Pepito-electronics/Integrated-KART/README.md

# Integrated-KART
Conception d'un KART électrique
