Pepito-electronics/Integrated-KART/Gr13_rapport_final.pdf

# ISAT – EPHEC

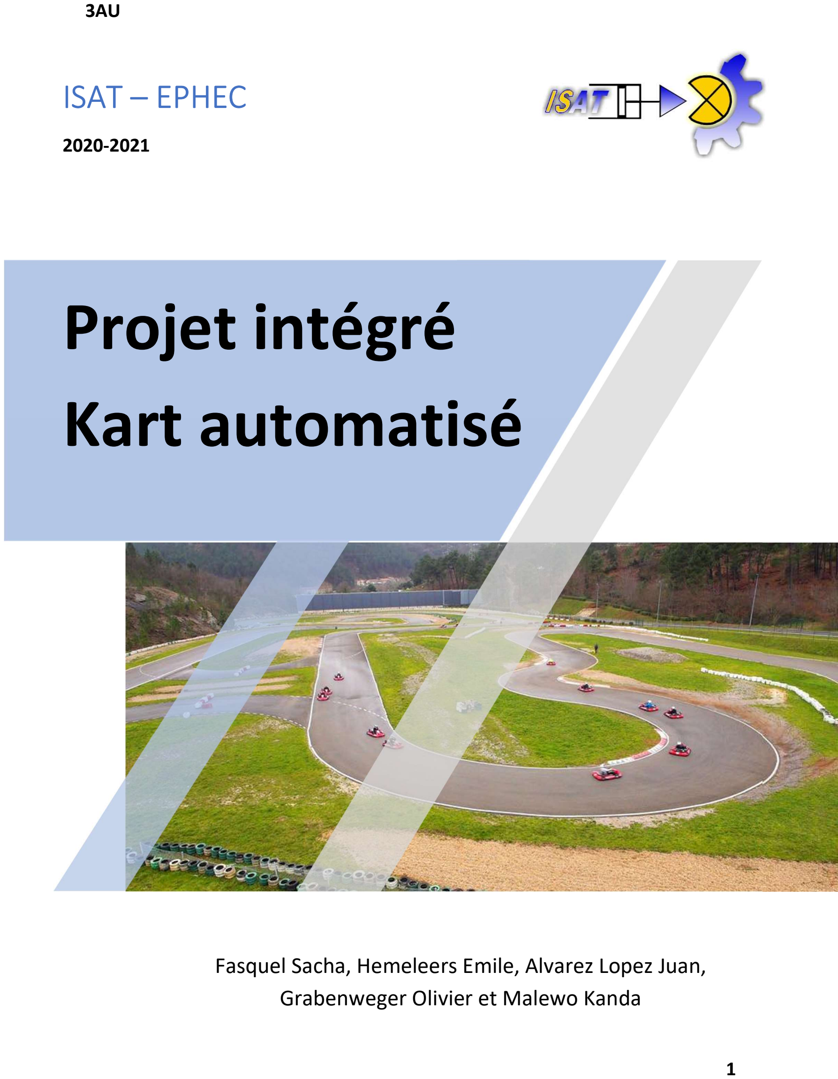
[picture p1: page 1]

3AU

1

2020-2021

Fasquel Sacha, Hemeleers Emile, Alvarez Lopez Juan,

## Grabenweger Olivier et Malewo Kanda

# Projet intégré Kart automatisé

2

A. Table des matières
B. Fonctions | Error! Bookmark not defined.
Capteur recul | Error! Bookmark not defined.
Puissance | Error! Bookmark not defined.
Autres composants | Error! Bookmark not defined.
D. Gestion moteur | Error! Bookmark not defined.

3

## A. Cahier des charges

Notre projet consistera à la réalisation d’un véhicule électrique (usage non routier) doté de capteurs. Cela nécessitera une gestion électronique, de l’automatisation et de la régulation via des composants dédiés ainsi que par des microcontrôleurs. Une personne à bord du véhicule pourra le manœuvre dans le sens avant et arrière de la marche et pourra tourner grâce à un volant. Un tableau de bord sera écran intégré pour afficher vitesse, niveau de charges des batteries, voyant témoins des phares, voyant témoins d’introduction clé.

Objectifs :

Notre objectif, faire avancer le kart et établir la communication entre diffèrent élément de gestion

## B. Schémas, plans et maquettes

Eclairage

Nous avons sur le kart un phare avant, un phare arrière et deux clignotants à l’arrière.
Les phares avant et arrière sont commandé via des transistors S8050 de deux façons différentes. Soit on peut les allumer/éteindre via un bouton sur le HMI soit si la luminosité devient basse, ils s’allument automatiquement. Et se rééteignent lorsque la luminosité redevient assez haute.
Les clignotants, piloté par des transistors, sont pour l’instant seulement activé lorsque la pédale de frein est actionnée.

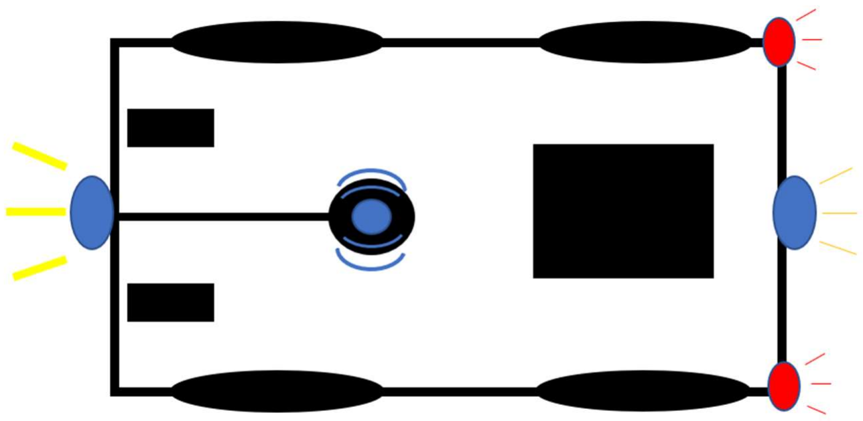
[picture p2: figure]

4

Klaxon

Alimenté en 12v et piloté grâce à un transistor lui-même piloté par le microcontrôleur.

Electronique

Cette partie se compose de deux ESP qui communiquent entre eux via le protocole CAN grâce à deux modules mcp2515 CANSPI.

Module 1 gestion tableau de bord (ESP32)

Situé dans le tableau de bord à l’avant du véhicule.
- Ce module sera relié avec un écran intelligent (Utilisation du Nextion 3.5 pouces)
- Il sera le module principal de tout notre kart.
- Capteur de vitesse (effet Hall), capteur de pression, clé RFID, boutons, PCB avec transistors pour l’éclairage, klaxon.
- Communication CAN avec le module 2
- …
Tout d’abord il convient de présenter notre « tableau de bord », en effet étant donné que le kart est susceptible d’être exposé à la pluie, il convenait de protéger les éléments électroniques. Pour ce faire nous avons imprimé en 3D le boitier suivant :

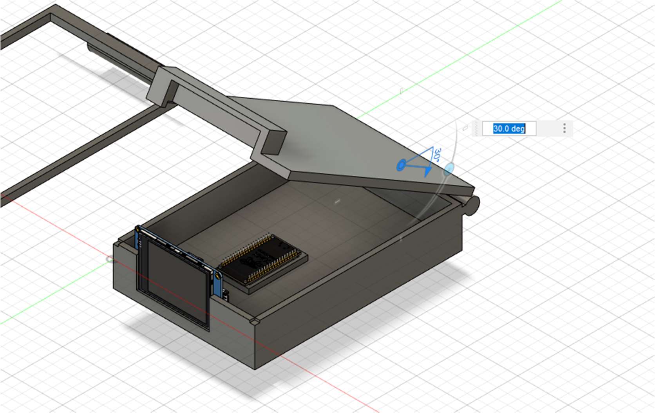
[picture p3: figure]

5

Dont voici, les différentes pièces.

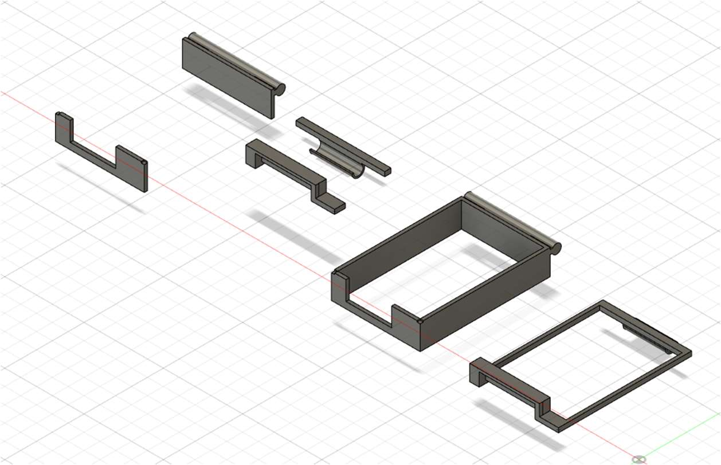
[picture p4: figure]

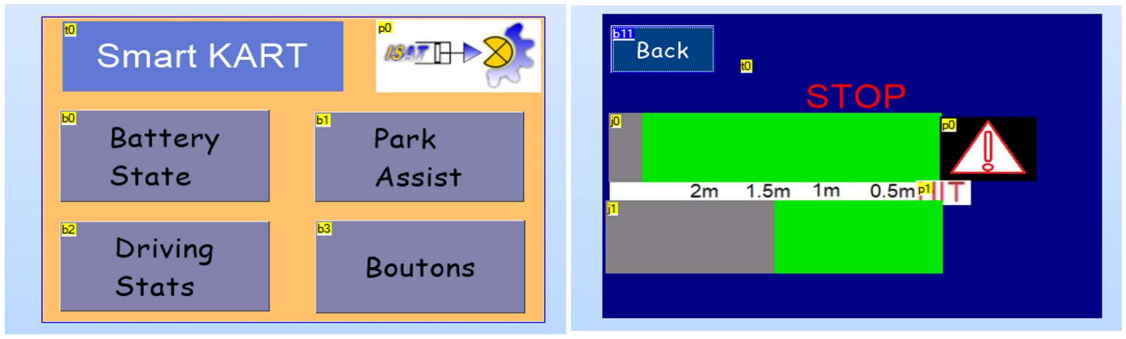
[picture p5: figure]
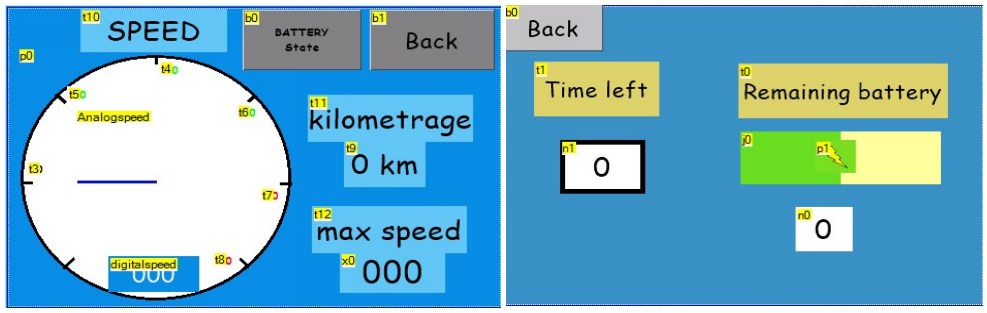
[picture p6: figure]

6

Voici quelques images de notre Nextion.

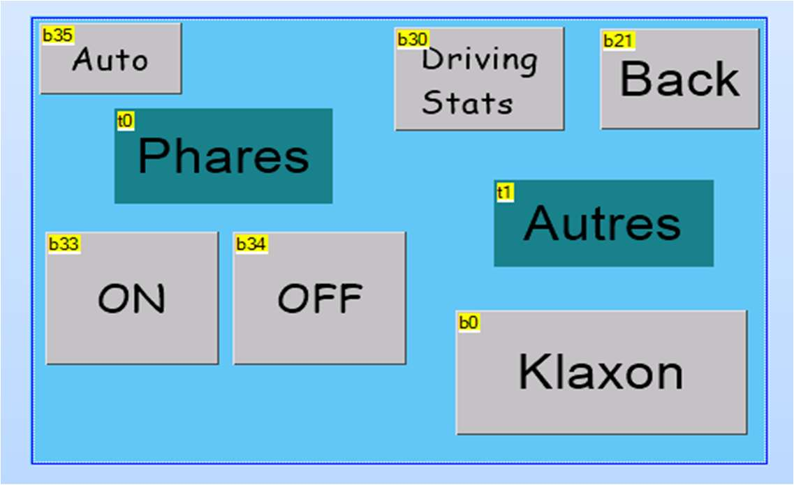
[picture p7: figure]

La communication avec le nextion est une « simple » communication série, en effet même si le protocole utilisé est relativement simple, l’interaction reste assez délicate. En effet, envoyer des données vers un objet non affiché cause des problèmes, nous avons dès lors du ruser pour structurer notre code se sorte que les données ne soient envoyées que quand la bonne page était affichée. Pour ce faire nous avons exploité la bibliothèque nextion.h mais les fonctions d’écriture de celle-ci étaient fort complexes alors que l’écriture de données est assez simple. Le code comporte donc des fonctions écrites par nous-mêmes pour l’écriture et une gestion d’évènements asynchrones pour la réception.

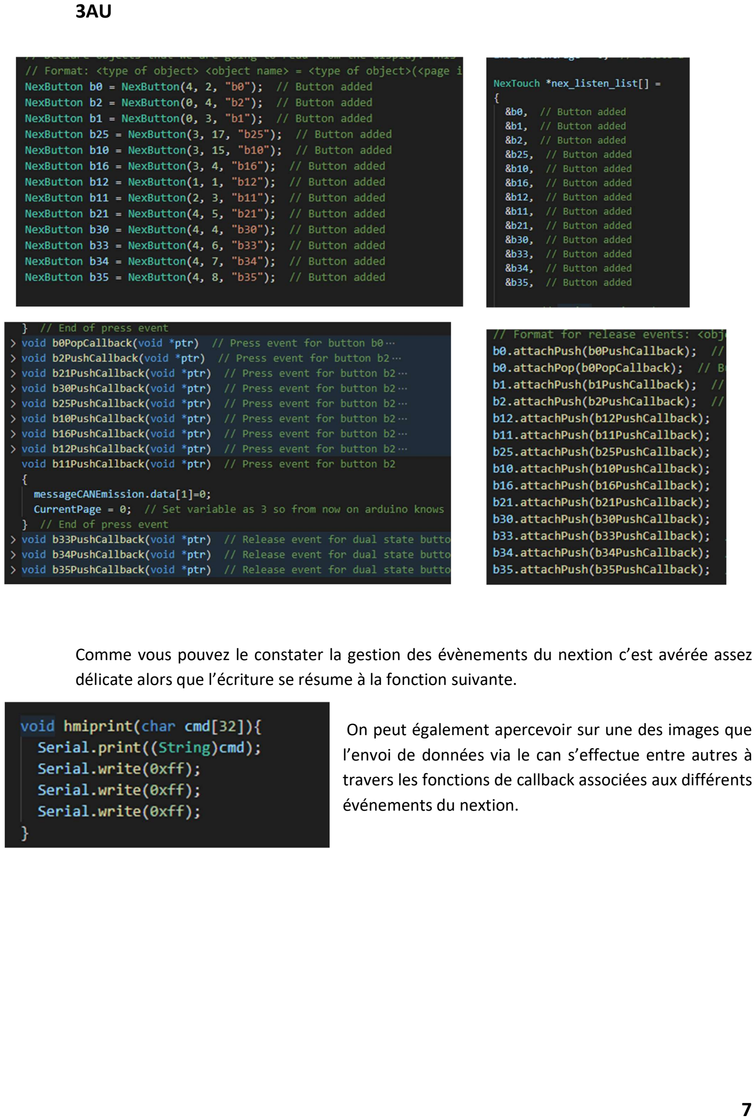
[picture p8: page 7]

7

Comme vous pouvez le constater la gestion des évènements du nextion c’est avérée assez délicate alors que l’écriture se résume à la fonction suivante.

On peut également apercevoir sur une des images que l’envoi de données via le can s’effectue entre autres à travers les fonctions de callback associées aux différents événements du nextion.

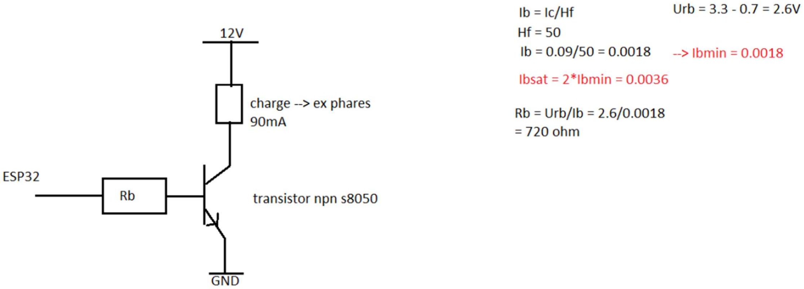
[picture p9: figure]

8

Dimensionnement des transistor

Module 2 gestion des capteurs et actionneurs arrière (EPS32)

Sur ce module se trouvent tous les composants (capteurs, …) situés à l’arrière du kart, en effet parce qu’il était peu pratique de tirer des câbles pour chaque capteur nous avons mis en place une communication CAN.

Communication CAN

Le bus CAN (Control Area Network) est un moyen de communication série qui supporte des systèmes embarqués temps réel avec un haut niveau de fiabilité. Ses domaines d'application s'étendent des réseaux moyens débits aux réseaux de multiplexages faibles coûts. Il est avant tout à classer dans la catégorie des réseaux de terrain utilisé dans l'industrie. La structure du protocole du bus CAN possède implicitement les principales propriétés suivantes :
- Hiérarchisation des messages.
- Garantie des temps de latence.
- Souplesse de configuration.
- Détections et signalisations d'erreurs.
- Retransmission automatique des messages altérés dès que le bus est de nouveau au repos.

9

- Distinction d'erreurs : d'ordre temporaire ou de non-fonctionnalité permanente au niveau d'un nœud, déconnexion automatique des nœuds défectueux.
La transmission des données est effectuée sur une paire filaire différentielle. La ligne est donc constituée de deux fils :
- CAN L (CAN LOW),
- CAN H (CAN HIGH).
Le CAN est un bus de terrain, soumis à des parasites importants. La transmission en paire différentielle permet donc de limiter ces problèmes.

Nous n’utilisons pas plus de 8 données transmises entre les deux cartes nous avons donc simplifié au maximum les trames néanmoins nous sommes conscients qu’il peut être très intéressant de différencier les différentes trames émises où reçues. Nous détaillerons en premier le protocole mis en place pour ensuite discuter des améliorations potentielles.
Nous avons défini des bytes précises sur lesquels nous communiquons des données, par exemple de l’arrière vers l’avant le byte 1 contiendra toujours l’état de la LDR, la photorésistance, afin d’allumer les phares.
De la même manière toutes les autres bytes peuvent être utilisés. Notons que nous sommes ici limités à un maximum de 8 données envoyées et reçues.
Un Protocole plus complet serait d’attribuer un caractère de début à chaque donnée ainsi nous pouvons envoyer autant de données que nous voulons, par exemple envoyer la valeur de la LDR comme ceci : « <1 » ici le « < » fait office de marqueur pour indiquer que c’est la LDR qui est transmise, et nous pouvons même imaginer dans le cas d’un très grand nombre de données différents des marqueurs de plusieurs bytes. Néanmoins vu la simplicité des données transmises nous avons décidé de rester simple non sans avoir exploré les possibilités que nous avions.

Gestion des différents capteurs

Avant tout il est nécessaire de préciser que deux ESP32 sont installé dans le kart, un à l’avant et un à l’arrière. Ils communiquent entre eux et gèrent chacun différents équipements qu’on a implémenté dans le projet.
ESP32 Avant | ESP32 Arrière
HMI | LDR
Capteur Ultrason | Capteur Ultrason
Capteur Effet hall | Capteur Effet hall
Phare | Phare
Klaxon | 2 clignotants

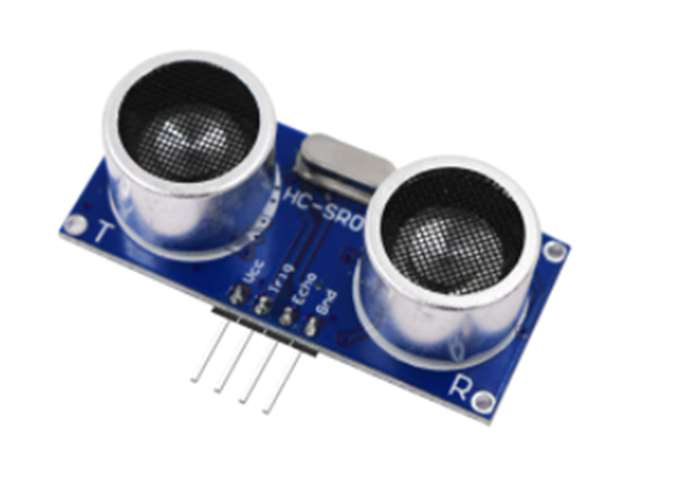
[picture p10: figure]

10

Notre kart a été doté de différents capteurs afin d’ajouter une dimension automatique. Grâce à ceux-ci, diverses données sont récoltées et traitées en fonction de leur utilité. Certains capteurs serviront à afficher des données sur l’HMI et d’autres à automatiser certaines fonctionnalités.

Le kart sera donc équipé de deux capteurs ultrasons, un à
l’avant, un à l’arrière qui auront la même fonction. Ils serviront
à éviter de se cogner contre des obstacles quand on essaye des se garer. Pour activer les détecteurs il faut activer le mode « parking » sur le HMI. Ceci fait, on pourra observer sur l’écran à quelle distance se situent les obstacles s’il y en a.
Les capteurs ultrasons utilisés ici sont des HC-SR04, des capteurs pas des plus précis mais dont le coût et la distance de détection convenait parfaitement à notre projet.

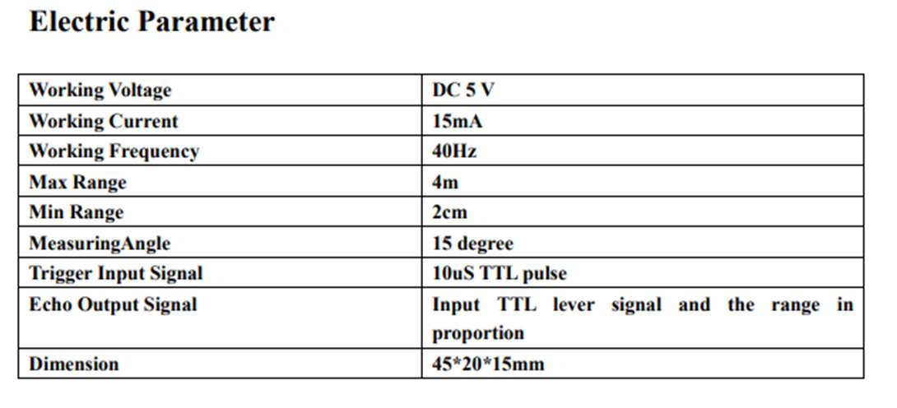
[picture p11: figure]

Deux capteurs effet hall ont aussi été monté sur le véhicule et remplissent des objectifs bien différent. Le premier servira à détecter si la pédale de frein est enclenchée afin de transmettre un signal au microcontrôleur de l’arrière, ce qui allumera les clignoteurs arrière en continu sur l’intervalle de temps pour lequel le frein est actif. Cela sert à prévenir d’éventuel autres véhicules de se tenir à une certaine distance de notre kart afin de ne pas nous emboutir lors de la phase de freinage.

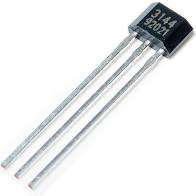
[picture p12: figure]

Le deuxième capteur effet hall sert à calculer la vitesse de notre véhicule. Ce capteur étant un TOR et se mettant à l’état haut uniquement lorsqu’on passe un aimant devant celui-ci, nous avons dû élaborer un calcul qui a directement été implémenté dans le programme de l’ESP32 situé à l’avant. Nous avons donc collé un aimant dans une des roues arrière et mis le capteur à une distance de 2 à 3 cm. La vitesse du kart sera dès lors relevé à partir d’un calcul qui se base sur la circonférence du cercle tracé par la course de l’aimant autour de l’axe de la roue et du temps qu’il met pour l’effectuer. La vitesse sera affichée sur le HMI.

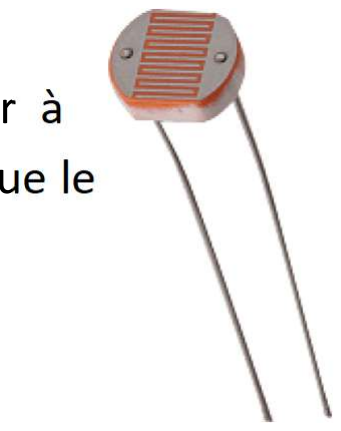
[picture p13: figure]
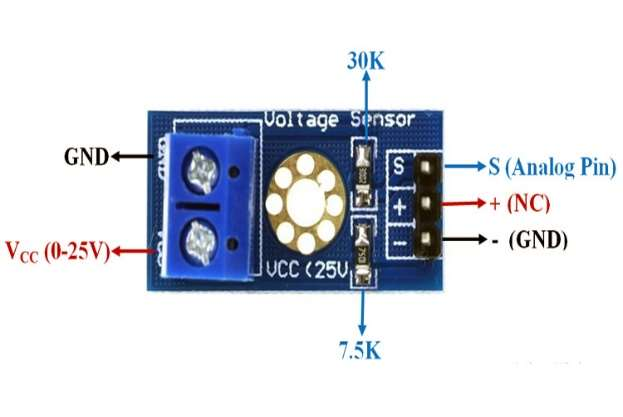
[picture p14: figure]
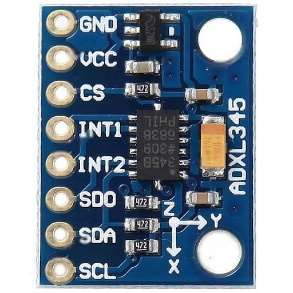
[picture p15: figure]

11

Comme mentionné un peu plus haut, une photorésistance va servir à allumer automatiquement les phares, à l’avant comme à l’arrière, lorsque le
niveau de luminosité passe en dessous d’un certain seuil.

Il y a aussi un élément (qui ne peut pas s’appeler capteur) qui permet de mesurer la tension de la batterie. Il s’agit d’un pont diviseur de tension qui est sous la forme d’un module compose d’une résistance de 30kΩ et 7,5kΩ.

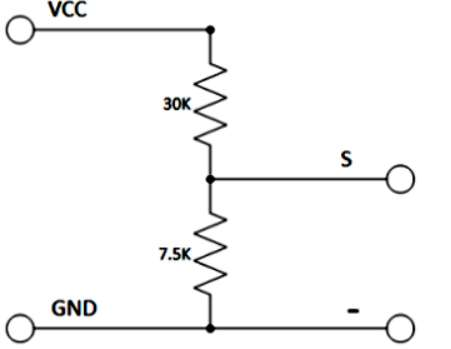
[picture p16: figure]

L’élément que nous avons rajouté est un accéléromètre 3 axes qui nous permet de calculer l’accélération et le déplacement du kart. Le tout sera affiché sur l’écran LCD.

Son fonctionnement est expliqué en détail dans la vidéo de présentation.

Code de l’ESP32 Arrière

#include <ACAN2515.h>

#include <HCSR04.h>

/*
* Broches pour le chip select et l'interruption du MCP2515 */

static const byte MCP2515_SCK = 26 ; // SCK input of MCP2517 static const byte MCP2515_MOSI = 19 ; // SDI input of MCP2517
static const byte MCP2515_MISO = 18 ; // SDO output of MCP2517

static const byte MCP2515_CS = 17; // CS input of MCP2515 (adapt to your design) static const byte MCP2515_INT = 21 ; // INT output of MCP2515 (adapt to your design)

/*
* L'objet pour piloter le MCP2515. SPI designe l'objet
* utilise pour la connexion SPI car sur certaines cartes * notamment les Teensy, il peut y avoir plusieurs SPI. */
ACAN2515 controleurCAN(MCP2515_CS, SPI, MCP2515_INT);

12

/*
* La frequence du quartz du MCP2515 en hertz.
*/
static const uint32_t FREQUENCE_DU_QUARTZ = 20UL * 1000UL * 1000UL ; // 20 MHz

/*
* La fréquence du bus CAN
*/
static const uint32_t FREQUENCE_DU_BUS_CAN = 125ul * 1000ul;

/*
* Un objet pour le message CAN. Par defaut c'est un message * standard avec l'identifiant 0 et aucun octet de donnees */
CANMessage messageCANReception;
CANMessage messageCANEmission1;

// PIN des différente Capteurs/Actionneurs

const int LDR = 15; //LDR ou photorésistance const int hallPin = 22; //Capteur effet hall const int pharearriere = 23; //phare arriere
const int clignoteurG = 12; //clignoteur gauche
const int clignoteurD = 14; //clignoteur droite
UltraSonicDistanceSensor distanceSensor(4, 5); //PIN TRIGGER et ECHO du Ultrason

//Différentes variables
bool parking;
int lumi;
int sensorValue;
bool flag_sensor;
uint8_t stateLumi = 0;
bool oldstate;
int distance;

//Fonction pour allumer les clignoteurs si on freine (que le capteur ne detecte plus l'aimant) void Halldetect()
{
if (sensorValue == LOW)
{
Serial.print("Halldetect"); digitalWrite(clignoteurG,sensorValue); digitalWrite(clignoteurD,sensorValue); }
else if (sensorValue == HIGH)
{
digitalWrite(clignoteurG,sensorValue); digitalWrite(clignoteurD,sensorValue); }
}

void setup()
{
//Initialise le Serial
Serial.begin(115200);
//Initialise le SPI

13

SPI.begin (MCP2515_SCK, MCP2515_MISO, MCP2515_MOSI) ; Serial.println("Configuration du MCP2515");
//Fixe la vitesse du bus a 125 kbits/s
ACAN2515Settings reglages(FREQUENCE_DU_QUARTZ, FREQUENCE_DU_BUS_CAN);
// Demarre le CAN
const uint16_t codeErreur = controleurCAN.begin(reglages, [] { controleurCAN.isr(); } ); // Verifie que tout est ok
if (codeErreur == 0) {
Serial.println("Recepteur: configuration ok");
}
else {
Serial.println("Recepteur: Probleme de connexion"); while (1);
}

//Initialise les broche des LEDs pinMode(pharearriere, OUTPUT); digitalWrite(pharearriere,LOW); pinMode(clignoteurD, OUTPUT); digitalWrite(clignoteurD,LOW); pinMode(clignoteurG, OUTPUT); digitalWrite(clignoteurG,LOW);
//Configure la longueur de la trame d'envoi messageCANEmission1.len = 3;
//met le flag à zero
stateLumi = 0;
}
//fonction loop
void loop()
{
//Reception de donnee du CAN
if (controleurCAN.receive(messageCANReception)) { /* Un message CAN est arrive */
static uint32_t numero = 0; controleurCAN.receive(messageCANReception) ; Serial.println(messageCANReception.data[1]); //on reçois l'etat de parking
parking = messageCANReception.data[1];
}
//lecture de l'etat du capteur effet hall sensorValue = digitalRead(hallPin);
//fonction du capteur effet hall
Halldetect();
//SI parking passe à 1, on commence à envoyer des données de //notre ultrason
if (parking == 1)
{
//envoi de la donnee de la distance entre nous et un obstacle // via le capteur ultrasons
messageCANEmission1.data[1] = distance;
//vérification que le message a bien été envoyé
const bool ok = controleurCAN.tryToSend(messageCANEmission1); if (ok)
{
Serial.print("message ");
Serial.print("Distance ");

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
Serial.println(" envoyee !");
}
}
//lecture de la valeur de la photoresistance
lumi = analogRead(LDR);
Serial.println(lumi);
/* Dans les lignes ci-dessous, on envoie notre message seulement lorsqu'il y a un changement d'etat de notre LDR, c'est à dire si la valeur de la luminosité passe
au dessus ou en dessous de 2000. Cela allege le microcontrôleur qui ne dois donc pas envoyer des messages en permanence */
if (lumi < 2000)
{
stateLumi = 1;
}
else if (lumi >= 2000)
{
stateLumi = 0;
}
//si la luminosité est en dessous de 2000 et qu'elle //était avant au dessus de 2000
if (stateLumi == 1 && oldstate == 0)
{
messageCANEmission1.data[0] = stateLumi;
const bool ok = controleurCAN.tryToSend(messageCANEmission1); if (ok)
{
Serial.print("message ");
Serial.print("Allumer ");
Serial.println(" envoye !");
}
//on allume en meme temps les phare arriere digitalWrite(pharearriere,HIGH);
}
//si la luminosité est au dessus de 2000 et //qu'elle était avant en dessous de 2000 else if (stateLumi == 0 && oldstate == 1)
{
messageCANEmission1.data[0] = stateLumi;
const bool ok = controleurCAN.tryToSend(messageCANEmission1); if (ok)
{
Serial.print("message ");
Serial.print("Eteindre "); Serial.println(" envoye !");
}
//on eteind en meme temps les phare arriere digitalWrite(pharearriere,LOW);
}
//on sauvegarde la le flag precedent oldstate = stateLumi;
delay(1000);
}
*Pour la communication CAN entre les deux ESP32, nous utilisons la bibliothèques ACAN de Pierre Molinaro.

15

Dans le code ci-dessus, il y a plusieurs points intéressants à soulever.
D’abord, pour déclarer les PIN dédier au mcp2515 nous avons dû un peu chipoter car bien qu’il y ait des PIN dédiées sur l’ESP32 pour le SPI, nous avons rencontré quelques soucis qui empêchais le bon fonctionnement du programme. Nous avons donc modifié ces PIN par défaut pour des PIN qui ne posait pas de problème.

Code ESP avant

// CODE CARTE AV ==> HMI + CPT

#include <HCSR04.h>

#include <ACAN2515.h>

#include <Arduino.h>

#include <Nextion.h>

#include <SPI.h>

#define Front_light 4

#define HALL_PIN 23

#define Klaxon 16

#define ultraS_pin 25

#define ANALOG_PIN 34

UltraSonicDistanceSensor distanceSensor(32, 33); // Initialize sensor that uses digital pins 13 and 12.

static const byte MCP2515_SCK = 26 ; // SCK input of MCP2517 static const byte MCP2515_MOSI = 19 ; // SDI input of MCP2517 static const byte MCP2515_MISO = 18 ; // SDO output of MCP2517

static const byte MCP2515_CS = 17 ; // CS input of MCP2515 (adapt to your design)
static const byte MCP2515_INT = 21 ; // INT output of MCP2515 (adapt to your design)

ACAN2515 controleurCAN(MCP2515_CS, SPI, MCP2515_INT);
static const uint32_t FREQUENCE_DU_QUARTZ = 20ul * 1000ul * 1000ul;
static const uint32_t FREQUENCE_DU_BUS_CAN = 125ul * 1000ul;

CANMessage messageCANEmission;
CANMessage messageCANReception1;

// Declare objects that we are going to read from the display. This includes buttons, sliders, text boxes, etc:
// Format: <type of object> <object name> = <type of object>(<page id>, <object id>, "<object name>");
NexButton b0 = NexButton(4, 2, | "b0"); // Button added
NexButton b2 = NexButton(0, 4, | "b2"); // Button added

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
NexButton b1 = NexButton(0, 3, | "b1"); // Button added
NexButton b25 = NexButton(3, 17, | "b25"); // Button added
NexButton b10 = NexButton(3, 15, | "b10"); // Button added
NexButton b16 = NexButton(3, 4, | "b16"); // Button added
NexButton b12 = NexButton(1, 1, | "b12"); // Button added
NexButton b11 = NexButton(2, 3, | "b11"); // Button added
NexButton b21 = NexButton(4, 5, | "b21"); // Button added
NexButton b30 = NexButton(4, 4, | "b30"); // Button added
NexButton b33 = NexButton(4, 6, | "b33"); // Button added
NexButton b34 = NexButton(4, 7, | "b34"); // Button added
NexButton b35 = NexButton(4, 8, | "b35"); // Button added

char buffer[100] = {0};
int CurrentPage = 0; // Create a variable to store which page is currently loaded

NexTouch *nex_listen_list[] =
{
&b0, // Button added
&b1, // Button added
&b2, // Button added
&b25, // Button added
&b10, // Button added
&b16, // Button added
&b12, // Button added
&b11, // Button added
&b21, // Button added
&b30, // Button added
&b33, // Button added
&b34, // Button added
&b35, // Button added

NULL // String terminated
}; // End of touch event list

long tm1,tm2,tm3,tm_v;
int vit;
bool etat=false;
bool mvt;

//int index;
char command_line[32];
bool isCommandReady;

int vitesse,max_speed;
char serialbuffer[32];
char serialbuffer2[32];
char recptbuffer[8];
int cst,cst1,cst2;
int phareState, distance2;

int distance;

int sensorValue;

17

bool flag_button,autoLight;

void calcul_v(){
// lecture du capteur a Effet Hall sensorValue = digitalRead( HALL_PIN );
// senseurValue = HIGH sans aimant
// senseurValue = LOW quand POLE SUD aimant sensorValue = not( sensorValue );
if (sensorValue == HIGH)
{
flag_button = 1;
}
if (flag_button == 1 && sensorValue == LOW) {
flag_button = 0;
tm2 = millis();
tm_v = tm2 - tm3;
vit =(0.0007536 / tm_v)*3600000; // avec 12cm de rayon tm3 = tm2;
}
}

void b0PushCallback(void *ptr) // Press event for button b0 {
digitalWrite(Front_light,HIGH); //Serial.print("klaxon");
//Serial.print("/n");
} // End of press event
void b1PushCallback(void *ptr) // Press event for button b0 {
CurrentPage = 2;
messageCANEmission.data[1]=1;
} // End of press event
void b0PopCallback(void *ptr) // Press event for button b0 {
digitalWrite(Front_light,LOW);
//Serial.print("klaxon");
//Serial.print("/n");
} // End of press event
void b2PushCallback(void *ptr) // Press event for button b2 {
CurrentPage = 3; // Set variable as 3 so from now on arduino knows page 3 is loaded on the display
} // End of press event
void b21PushCallback(void *ptr) // Press event for button b2 {
CurrentPage = 0; // Set variable as 3 so from now on arduino knows page 3 is loaded on the display
} // End of press event
void b30PushCallback(void *ptr) // Press event for button b2 {
CurrentPage = 3; // Set variable as 3 so from now on arduino knows page 3 is loaded on the display
} // End of press event
void b25PushCallback(void *ptr) // Press event for button b2

18

{
CurrentPage = 4; // Set variable as 3 so from now on arduino knows page 3 is loaded on the display
} // End of press event
void b10PushCallback(void *ptr) // Press event for button b2 {
CurrentPage = 0; // Set variable as 3 so from now on arduino knows page 3 is loaded on the display
} // End of press event
void b16PushCallback(void *ptr) // Press event for button b2 {
CurrentPage = 1; // Set variable as 3 so from now on arduino knows page 3 is loaded on the display
} // End of press event
void b12PushCallback(void *ptr) // Press event for button b2 {
CurrentPage = 0; // Set variable as 3 so from now on arduino knows page 3 is loaded on the display
} // End of press event
void b11PushCallback(void *ptr) // Press event for button b2 {
messageCANEmission.data[1]=0;
CurrentPage = 0; // Set variable as 3 so from now on arduino knows page 3 is loaded on the display
} // End of press event
void b33PushCallback(void *ptr) // Release event for dual state button bt0
{
digitalWrite(Front_light,HIGH);

//Serial.print("Front LIGHT");
//Serial.print("/n");
} // End of release event
void b34PushCallback(void *ptr) // Release event for dual state button bt0
{
digitalWrite(Front_light,LOW);

//Serial.print("Back LIGHT");
//Serial.print("/n");
} // End of relea
void b35PushCallback(void *ptr) // Release event for dual state button bt0
{
autoLight = 1;
//Serial.print("Back LIGHT"); //Serial.print("/n");
} // End of relea

////////////////////////// End of touch events

void hmiprint(char cmd[32]){ Serial.print((String)cmd); Serial.write(0xff);
Serial.write(0xff);

19

Serial.write(0xff);
}

void setup() {
// put your setup code here, to run once: tm1=millis();
max_speed=0;
pinMode(Front_light,OUTPUT); pinMode(Klaxon,OUTPUT);
Serial.begin(9600);

/* Demarre le SPI */
SPI.begin (MCP2515_SCK, MCP2515_MISO, MCP2515_MOSI) ; /* Configure le MCP2515 */ Serial.println("Configuration du MCP2515");
/* Fixe la vitesse du bus a 125 kbits/s */ ACAN2515Settings reglages(FREQUENCE_DU_QUARTZ, FREQUENCE_DU_BUS_CAN);
/* Demarre le CAN */
const uint16_t codeErreur = controleurCAN.begin(reglages, [] { controleurCAN.isr(); } );
/* Verifie que tout est ok */
if (codeErreur == 0) {
Serial.println("Configuration ok");
}
else {
Serial.println("Probleme de connexion"); //while (1);
}

messageCANEmission.len = 2;
//messageCANReception1.len = 1;

// Register the event callback functions of each touch event: // You need to register press events and release events seperatly.
// Format for press events: <object name>.attachPush(<object name>PushCallback);
// Format for release events: <object name>.attachPop(<object name>PopCallback);
b0.attachPush(b0PushCallback); // Button press b0.attachPop(b0PopCallback); // Button press b1.attachPush(b1PushCallback); // Button press b2.attachPush(b2PushCallback); // Button press b12.attachPush(b12PushCallback); b11.attachPush(b11PushCallback); b25.attachPush(b25PushCallback); b10.attachPush(b10PushCallback); b16.attachPush(b16PushCallback); b21.attachPush(b21PushCallback); b30.attachPush(b30PushCallback); b33.attachPush(b33PushCallback); // Dual state button bt0 release
b34.attachPush(b34PushCallback); // Dual state button bt0 release

20

b35.attachPush(b35PushCallback); // Dual state button bt0 release

// End of registering the event callback functions
}

void loop() {
nexLoop(nex_listen_list); // Check for any touch event if(CurrentPage == 0){ // If the display is on page 0, do the following:

}
if(CurrentPage == 1){ // If the display is on page 1, do the following:

}
if(CurrentPage == 2){ // If the display is on page 2, do the following:
distance = 100-distanceSensor.measureDistanceCm(); memset(serialbuffer,0,sizeof(serialbuffer)); sprintf(serialbuffer,"j0.val=%d",distance); hmiprint(serialbuffer);
memset(serialbuffer,0,sizeof(serialbuffer)); sprintf(serialbuffer,"j1.val=%d",distance2); hmiprint(serialbuffer);
delay(500);
}
if(CurrentPage == 3){ // If the display is on page 2, do the following:
if(tm1<millis()){

vitesse = analogRead(ANALOG_PIN);
cst = map(vitesse,0,4095,0,270);
cst1 = map(vitesse,0,4095,0,60); memset(serialbuffer,0,sizeof(serialbuffer)); sprintf(serialbuffer,"digitalspeed.val=%d",cst1); hmiprint(serialbuffer);

memset(serialbuffer,0,sizeof(serialbuffer)); sprintf(serialbuffer,"Analogspeed.val=%d",cst); hmiprint(serialbuffer);
if(vitesse>max_speed){
max_speed=vitesse;
cst2 = map(vitesse,0,4095,0,60);
}
memset(serialbuffer,0,sizeof(serialbuffer)); sprintf(serialbuffer,"x0.val=%d",cst2); hmiprint(serialbuffer);
tm1 = millis() + 500;

/*calcul_v();
cst = map(vit,0,60,0,270);

memset(serialbuffer,0,sizeof(serialbuffer));

21

318
319

sprintf(serialbuffer,"digitalspeed.val=%d",vit); hmiprint(serialbuffer);

memset(serialbuffer,0,sizeof(serialbuffer)); sprintf(serialbuffer,"Analogspeed.val=%d",cst); hmiprint(serialbuffer);
if(vit>max_speed){
max_speed=vit;
}
memset(serialbuffer,0,sizeof(serialbuffer)); sprintf(serialbuffer,"x0.val=%d",max_speed); hmiprint(serialbuffer);
tm1 = millis() + 500;*/
}
}

if(CurrentPage == 4){ // If the display is on page 4, do the following:

}

if (controleurCAN.receive(messageCANReception1)) {
//Un message CAN est arrive controleurCAN.receive(messageCANReception1) ; phareState= messageCANReception1.data[0]; distance2 = messageCANReception1.data[1]; distance2 = 100-distance2;
// l'etat de la LED correspondante est change if(autoLight){
digitalWrite(Front_light,phareState);
}
}
}

PCB

Pour la réalisation du PCB nous sommes passé par plusieurs schéma en fonction de nos décisions. Au début, nous avions émis l’idée d’utiliser des ESP8266. Mais nos idées

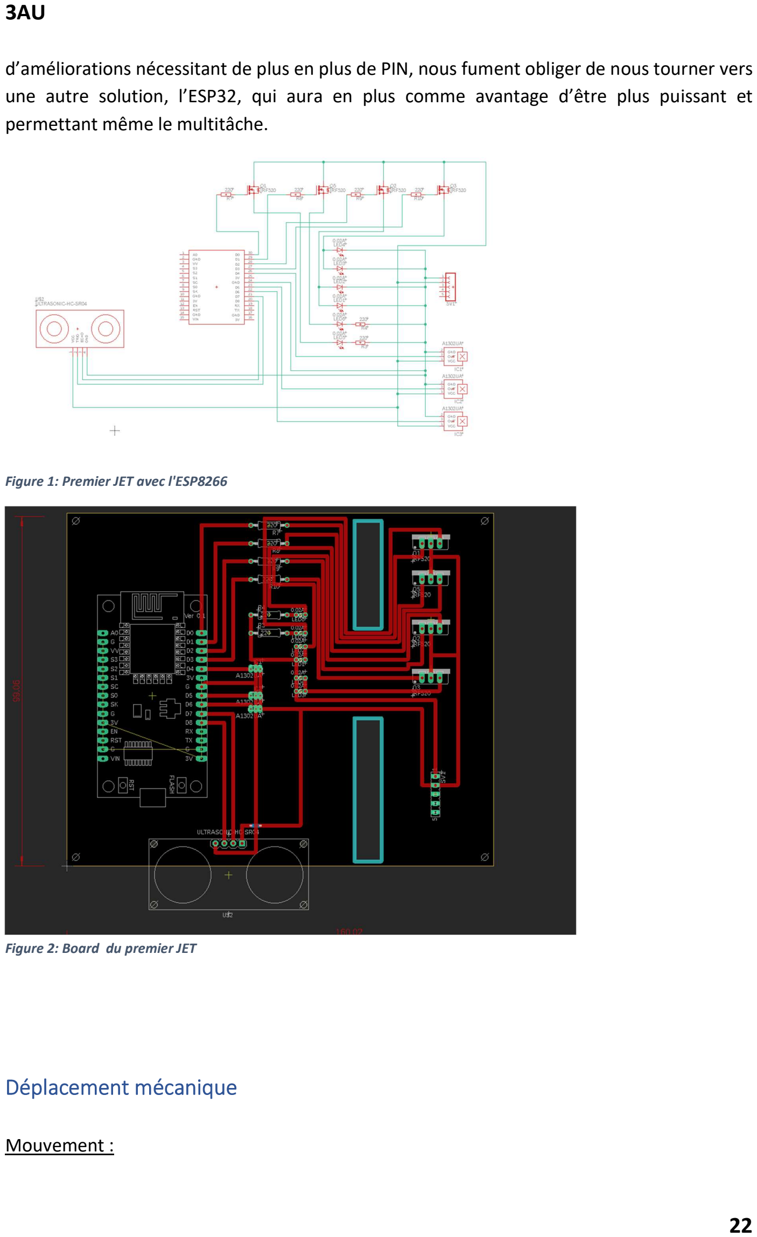
[picture p17: page 22]

22

d’améliorations nécessitant de plus en plus de PIN, nous fument obliger de nous tourner vers une autre solution, l’ESP32, qui aura en plus comme avantage d’être plus puissant et permettant même le multitâche.

Figure 1: Premier JET avec l'ESP8266

Figure 2: Board du premier JET

Déplacement mécanique

Mouvement :

23

Notre kart se meut à l’aide d’un moteur électrique. Ce moteur est un moteur à courant continu avec un tension maximale de 36 Volts et une puissance de 1000 Watts. La transmission entre l’axe du moteur et l’axe des roues arrière est établie par une chaîne. Voici un schéma de principe :

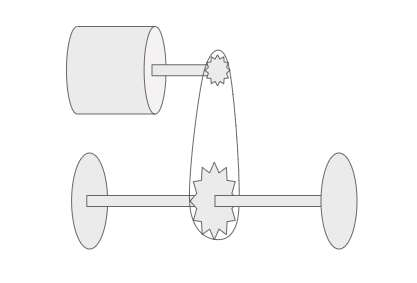
[picture p18: figure]

Nous nous sommes très vite rendu compte qu’il faudrait tendre la chaîne. Nous pensions la réduire de taille jusqu'à ce qu’elle soit tendue mais cette solution n’est pas réaliste pour 2 raisons. La première, est le fait qu’un maillon fait varier de 2 ou 3 cm la taille totale de la chaîne. Il est dès lors impossible d’ajuster la chaîne correctement car nous ne tombions pas sur une taille acceptable. La deuxième raison est le fait que tout notre système de transmission n’est pas totalement fixe : l'accélération induit un stress qui déforme temporairement les supports, les axes, (…), nous avons donc mis un tendeur de chaîne qui s’adapte en fonction du stress imposé. Voici le schéma de principe définitif de la transmission :

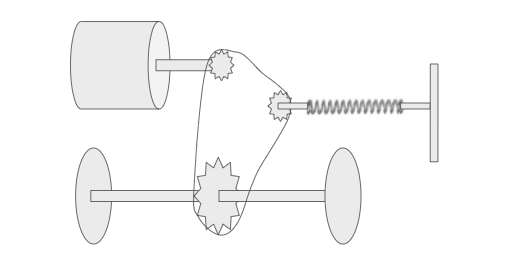
[picture p19: figure]

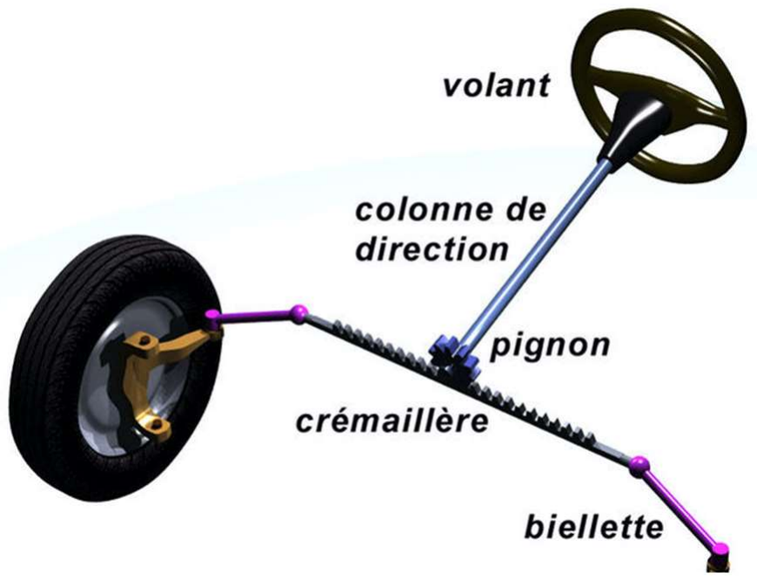
[picture p20: figure]

24

Le diamètre du pignon de l’axe des roues est plus grand que celui de l’axe du moteur. Ce choix est justifié par le fait que notre moteur DC à une vitesse de rotation qui, dans un monde idéal, donnerait 89 km/h (Le calcul a été fait à partir de la vitesse de rotation maximale du moteur et de la taille des roues du kart). Cette vitesse n’était pas dans notre cahier de charge, nous avons choisi les plateaux en fonction de cela. Malgré tout, quelques choix ont été empiriques : la conception mécanique n’étant pas dispensée dans notre cursus, nous avons fait des tests et nous avons choisi les composants qui fonctionnaient le mieux.

Notre Kart manque légèrement de couple. Nous avons sous-estimé le poids final : le kart, l’utilisateur, le moteur et tous les composants se rapprochent des 100 kilos… Il en résulte que le démarrage à l’arrêt est peu dynamique. Le démarrage en côte est lui impossible. Nous aurions dû mieux dimensionner les pignons mais nous avons récupéré de vieux vélos et n’avions pas tellement d’autres choix. De plus, la partie mécanique nous a pris beaucoup plus de temps que nous le pensions : nous avons fait le choix de continuer le projet en l’état car la partie mécanique n’est pas celle qui a motivé le choix de faire ce projet. Il ne faut pas oublier que nous sommes en automatique et pas en électromécanique.

Freinage :

Le freinage est fait de manière la plus classique qu’il soit : nous avons mis un câble qui va de la pédale de frein à l’arrière du véhicule. Lorsque l'utilisateur freine, le câble se serre. Ce câble est relié à un frein à disque qui freine l’axe arrière des roues. Lorsque l'utilisateur relâche le frein, un système de ressort, intégré dans le frein à disque repousse le câble dans sa position initiale. La vitesse du kart n’étant pas trop élevée, ce système de frein est suffisant pour l’arrêter en quelques secondes.

Direction :

Nous avons utilisé une crémaillère de direction pour faire tourner le kart. Le volant est fixé à un arbre de transmission. Au bout de cet arbre, se trouve
une roue dentée. La roue dentée est sur la crémaillère, ce
qui permet de transformer un mouvement circulaire en un
mouvement rectiligne.
Le schéma ci-dessus permet de bien visualiser le principe de fonctionnement du type de crémaillère de direction que nous avons utilisé. Ce type de crémaillère est le plus simple à mettre en place. Beaucoup d’autres crémaillères se basent le même principe mais intègrent de l’électronique et/ou

25

l’hydraulique (Comme les directions assistées des voitures modernes).

Gestion de l’alimentation et sécurité

Le contrôleur moteur n’est pas directement lié aux batteries directement.
Nous avons mis en place un élément intermédiaire capable d’augmenter la tension des batteries (en parallèles) jusqu’à 36v. Cet élévateur a été scrupuleusement sélectionné pour admettre un courant jusque 27 ampères. Ce circuit de puissance est relié aux bornes bien solides avec des connecteurs spécifiques ainsi que du câblage au 6mm²
. Cet élévateur de
tension est composé d’un fusible de 40 ampères.

Composants

- MicroControleurs 2X
- Capteur ultrason HC04
- Capteur effet hall A3144
- Ecran Nextion 3.5 pouces
- Relais 5v
- Boutons
- DHT11
- RFID-RC522
- Photorésistance
- Élévateur de tension 30A 10-60V
- Élévateur de tension 3A
- Klaxon 12v
- Cables,ressort,...

## C. Electronique de puissance gestion moteur

L’objectif de l’électronique de puissance et de nous permettre de contrôler, alimenter et réguler le moteur à courant continue via plusieurs modules diffèrent qui vont être expliqué, avec un peu plus de détail, dans les paragraphes suivants.

Contrôleur moteur DC
Le contrôleur de moteur à balais est un appareil électronique qui permet la régulation de la vitesse de rotation d’un moteur à balais par l’application d’une tension de 36VDC à l’appareil. Cet appareil s'alimente avec une tension de 36VDC pour des courants comprises entre 30 à 32A max et est compatible pour des moteurs d’une puissance de 1000W. Nous pouvons y brancher des batteries de voiture avec des charges 12 à 17AH.

26

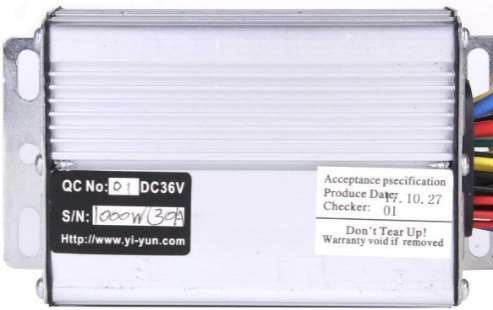
[picture p21: figure]

L’appareil et composé de plusieurs ports d’entrées et sorties :

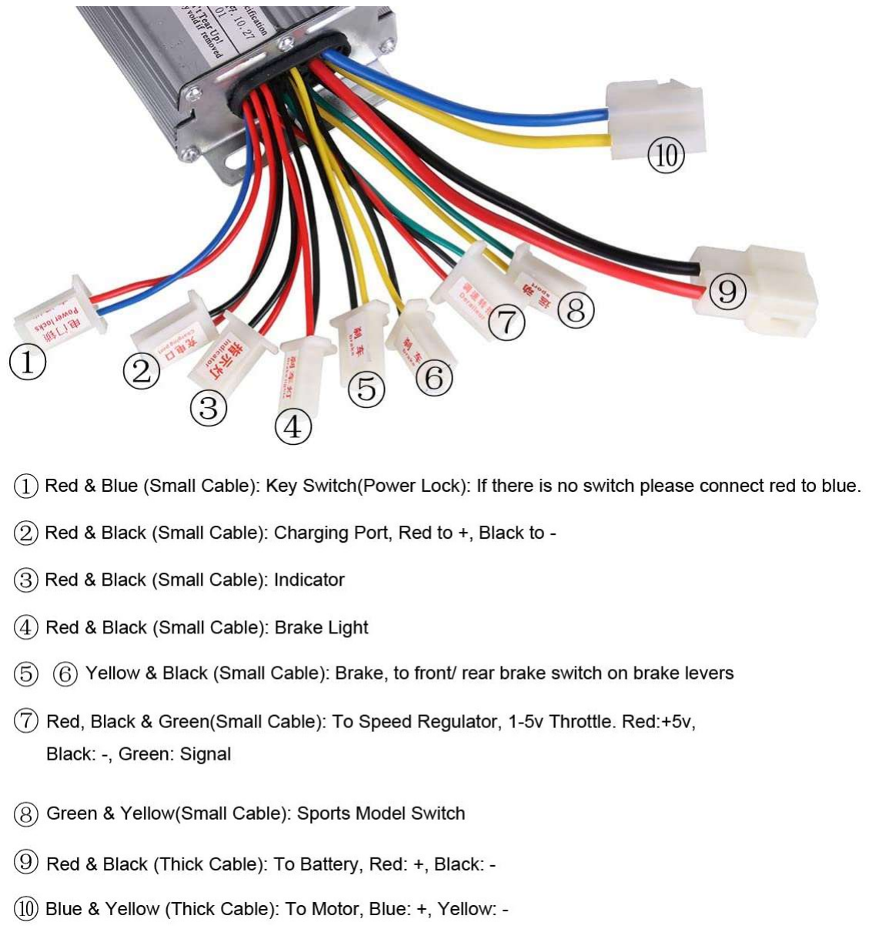
[picture p22: figure]

### 1. Port pour la connexion d’un interrupteur à clé (Power Lock) 2. Port de charge des batteries

a. Rouge (+), Noir (-) ;

### 3. Indicator 4. Port pour les phares des freins

5. 1

er Port de connexion pour le levier de frein
6. 2

nd Port de connexion pour le levier de frein

### 7. Régulateur de vitesse, port de connexion pour pédale d’accélération

a. Sortie 5V ;
b. Rouge (+5V), Noir (-), Vert (Signal) ;

### 8. Sport Model switch 9. Port de connexion batterie 36VDC 10. Port de connexion moteur à Balais

a. Bleu (+), Jaune (-) ;

27

Par la description de l’appareil, la connexion de différent module devient très simple et plus aisée. Nous y connecterons essentiellement une pédale d’accélération, des batteries en séries et un moteur de 1000W.

Pourquoi avoir choisi un contrôleur de moteur à balais ?
A la base, nous étions partis sur la conception d’un hacheur 4 quadrants composé de mosfet, pour des vitesses de commutation rapide et pour supporter des grands courants, contrôlé par un signal PWM d’un Arduino. Nous avons dû, hélas, comprendre, par le billet de l’un de nos professeurs, que cette idée n’était pas faisable à notre niveau dans le cursus scolaire. En effet, à partir d’un certain courant, les composants électroniques ne réagiraient pas comme nous le voudrions et que le hacheur ne se limiterait pas qu’à de simple mosfet mis en série et parallèle. Il aurait alors fallu penser à un moyen de réguler la tension, éviter les retours de courant, de moyen pour dissiper la chaleur et le courant, atténuer les bruits qui dans le circuit et un tas d’autres problèmes auxquels nous ne voulions certainement pas avoir à faire en vue du court temps que nous possédions pour développer ce type de solution pour le contrôle d’un moteur électrique. Il nous aurait fallu plus que 3 mois. Pour couronner le tout, le dimensionnement et la conception de ce type de module n’entre pas vraiment dans le cadre du cursus d’un automaticien.

Puis, nous avions cherché d’autre moyen de pour pouvoir contrôler notre moteur avec un module permettant de contrôler un moteur de 36V, 28A et 1000W. Il ne va sans dire que la recherche a été décevante surtout pour les 2 derniers paramètres où il nous a été impossible de trouver un module et peu coûteux pouvant supporter 28A et 1000W. Alors, nous nous sommes tournées vers une solution toute simple et qui était déjà disponible dès le départ et toute faite, le contrôleur de moteur à balais.

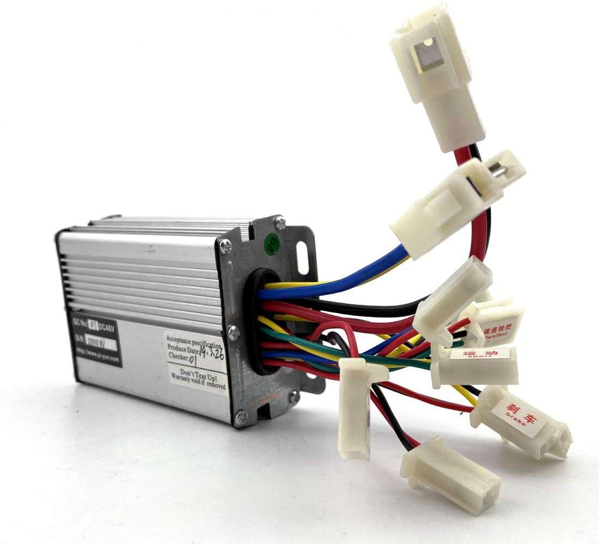
[picture p23: figure]

Au départ, elle devait juste nous servir à faire des tests pour faire avancer notre kart et voir comment nous allions disposer nos batteries pour développer le plus de couple possible au niveau du moteur et voir s’il nous faudrait rajouter des batteries supplémentaires. L’idée était, vraiment, d’en concevoir un nous-même.

28

Au final et suite aux problèmes énoncé, nous avons choisi de l’utiliser dans notre projet et il y a beaucoup d’avantage avec cet appareil. Toute la régulation électronique se fait grâce à cette petite boit très légèreté. Plus besoin de penser aux nombreux problèmes énumérés avant, l’appareil les gèrent. Il est doté d'une protection de la batterie, et si la tension baisse, l'unité de commande s'éteint, ne coute pas très chère et, en plus, l’installation des modules est simplifiée grâce aux différentes connexions.
Les caractéristiques du contrôleur en ont fait un choix de première puisque celui-ci permet parfaitement de réguler notre moteur électrique (qui sera développer dans le paragraphe suivant). Il accepte des tensions de 36V pour de grande charge allant de 30 à 32A et est compatible avec des moteurs développant des puissances de 1000W. Ce dernier, est adapté pour les quadriporteurs électriques, les scooters, les scooters 3 roues de ville, les scooters jouets, partout où on veut des performances élevées donc excellent pour notre kart.

Moteur DC
Le moteur DC est un moteur électrique à balais pour scooter électrique développant une puissance de 1000W avec 3000Tr/min pour une tension à ses bornes de 36VDC et un courant continu de 28A.
Il est l’un des acteurs principaux de notre projet intégré. Grace au moteur, nous pouvons mouvoir le véhicule à notre guise.
Le moteur étant le premier appareil sur lequel nous nous sommes penchés, c’est à partir de ce dernier que nous avons pu faire le choix des batteries, modules de contrôle et rapports de transmission avec les roues (un pignon était déjà compris avec le moteur).

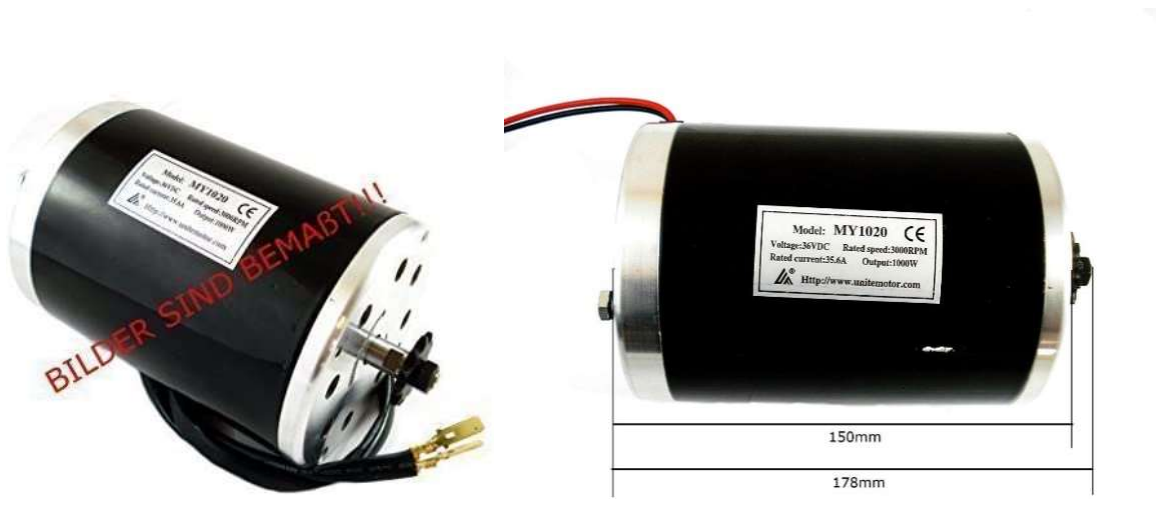
[picture p24: figure]

Le branchement est très simple, nous branchant les 2 files du moteur au contrôler de moteur électrique et le tour est joué. Mais, il ne suffit pas de seulement brancher le moteur au contrôleur, il faut aussi pouvoir appliquer les bonnes tensions et les bons courants afin d’être sûr de pouvoir développer le puissant nécessaire pour pouvoir faire avancer le kart. Au début du projet, nous avions utilisé 3 batteries 12V de 7ah chacune. Avec cette configuration, le moteur tournait vite mais manquait en couple car il avait du mal à tirer tout le poids du véhicule avec lui. Bien-sûr ceci n’était pas entièrement la faute des batteries mais

29

aussi de la transmission qui y joue beaucoup puisque nous l’avions modifiées par des chaines et roues dentée de vélo avec des rapport de transmission très peu élever. Bien-sûr, et nous l’avions compris, l’Idéal aurais été d’avoir des batteries qui puissent délivrer le courant nécessaire à notre moteur pour augmenter ce couple.
Afin d’augmenter le couple, il nous des batteries avec pouvant développer des courants plus importants. Grace aux formule suivante, nous comprenant l’utilité d’augmenter le courant :

o La force contre-électromotrice : E = k’ * Bs * Ω
où Ω correspond à la vitesse de rotation, ou pulsation, en rad/s reliée à la fréquence (nombre de tours par seconde) par la relation : f = Ω
2π
Bs est le champ statorique

Dans cette formule, on voit que la tension est proportionnelle à la vitesse de rotation du rotor donc ça veut dire qu’au plus on augmente la tension au plus on gagne en vitesse de rotation. Ce qui n’est pas requis dans ce cas pour faire avancer un kart avec du poids.

o Le couple électromécanique (moteur ou résistant) : T = k’ * Bs * Ii

Ici, on voit très bien que le courant lui est proportionnelle au couple électromécanique ce qui veut dire que pour pouvoir développer un couple suffisamment bon pour déplacer le kart, il nous faut augmenter le courant. Batteries

Les batteries sont 3 batteries au plomb de 12V et ont une chacune charge de 7Ah.

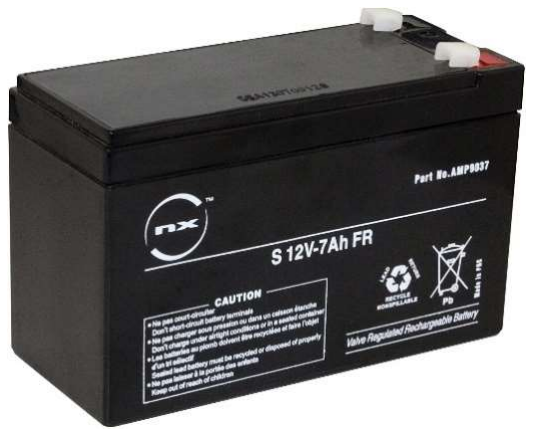
[picture p25: figure]

Elles serviront d’alimentation principale au contrôleur de moteur électrique et seront disposer en série à l’arrière du kart.

Pédale d’accélérateur

La pédale d’accélérateur est une pédale électrique alimenté en 5V par la borne « Throttle » du contrôleur de moteur avec un signal de contrôle positif, 0--5V.

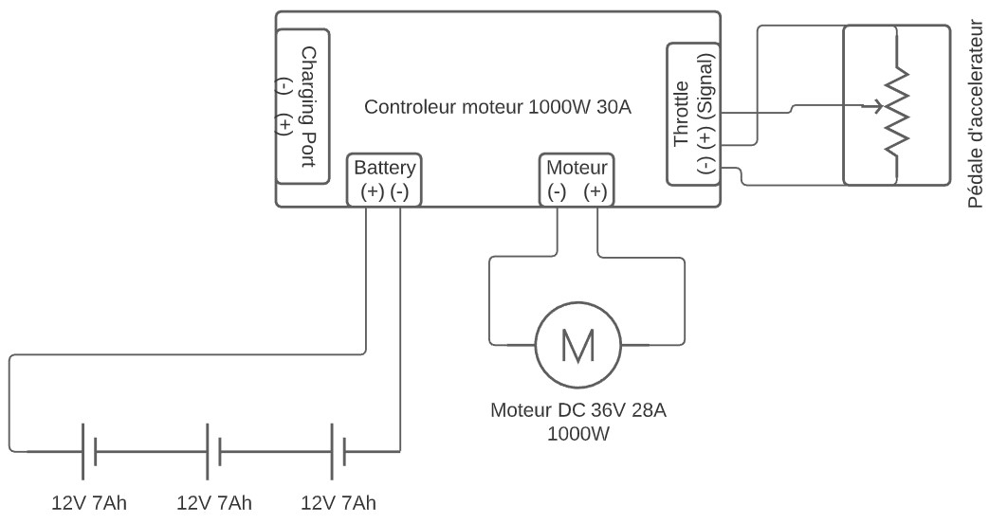
[picture p26: figure]

30

C’est par le billet de cette pédale que nous allons pouvoir réguler à notre guise la vitesse de rotation du moteur électrique via un 3ème fil « signal » qui permet de lire des tensions comprises entre 0 et 5V par le contrôleur pour moduler la tension de sortie au moteur (0-36V).

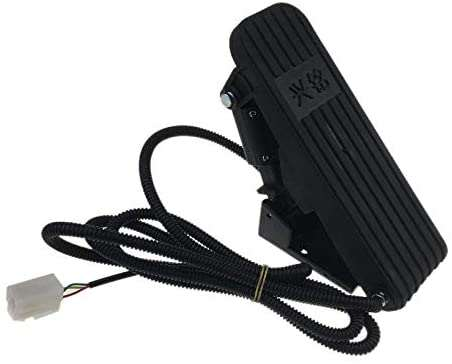
[picture p27: figure]

Le choix pour cette pédale était simple, elle acceptait les tensions de 5V que le contrôleur délivrait et dont on avait besoin pour le brancher.

Schéma de câblage

Schéma 3D

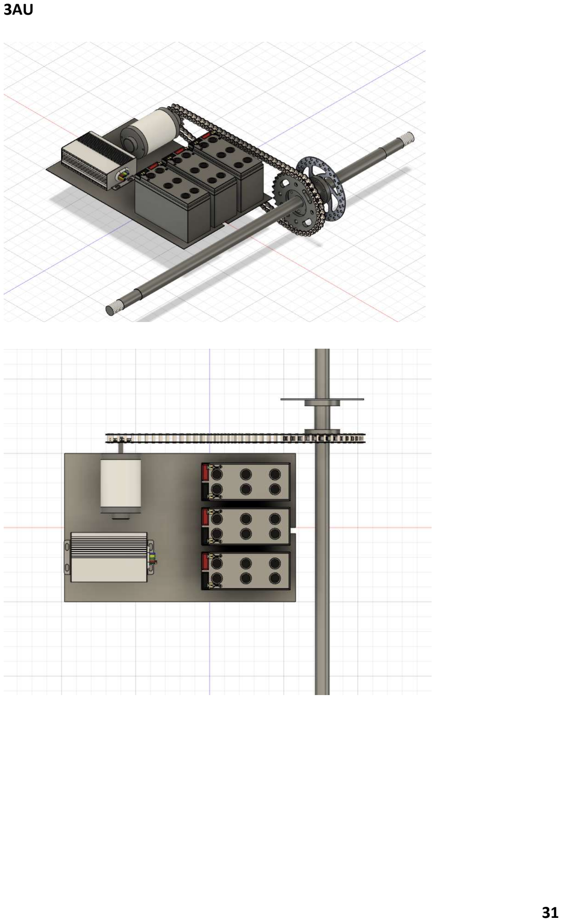
[picture p28: page 31]

31

32

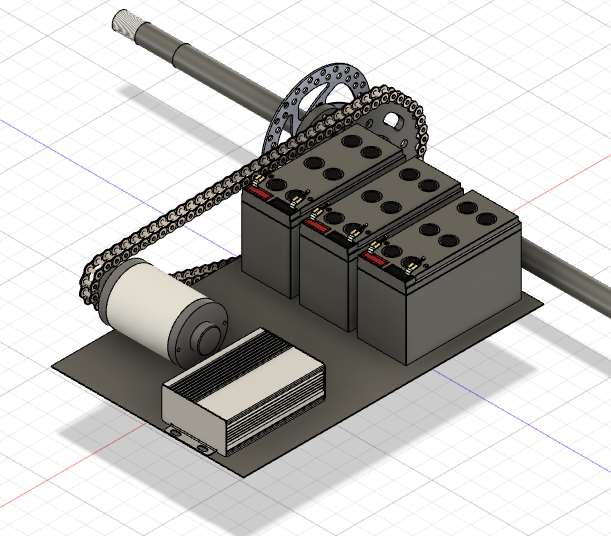
[picture p29: figure]

## D. Répartition des tâches

Fasquel Sacha : Sécurité et chargement
Hemeleers Emile : Mouvement
Alvarez Lopez Juan : Sécurité et chargement, Options, Eclairage, Communication Grabenweger Olivier: Options, PCB, Eclairage, Communication
Malewo Kanda : Mouvement

## E. Difficultés rencontrées

L’une des plus grandes difficultés que nous avons rencontrées fus la transmission par chaines. Au commencement du projet, nous avions pris comme référence un pignon déjà compris avec le moteur DC pour le dimensionnent de la chaine de transmission et du plateau (2nd roue dentée) à poser sur l’axe des roues arrière. Nous avions trouvé une chaine qui correspondais parfaitement au pignon du moteur et il nous manquait seulement un plateau que nous avions trouvé sur internet et dont les dimensions correspondaient elles aussi à la chaine. Vint le moment de tester notre chaine et le plateau que nous avions remarqués que

33

celles-ci ne correspondaient pas et n’allaient pas ensemble. Suit à cela, nous avions décidé d’en commander un autre avec des dimensions qui pourrait correspondre avec notre chaine. Là aussi, le même résultat que pour le précédent plateau, elle ne correspond pas à la chaine. Par manque de temps (à cause des livraison tardives) et peur de se retrouver avec toujours le même problème nous avions essayé des solutions en plastique dur par impression 3D qui furent elles aussi infructueuses.

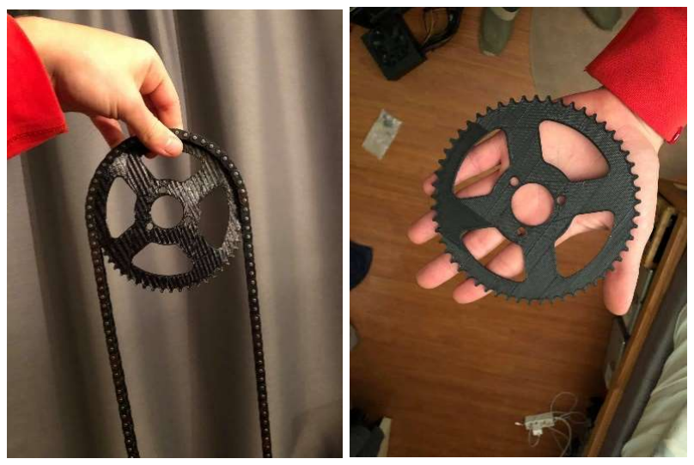
[picture p30: figure]

C’est alors qu’on nous conseilla d’utiliser des chaines et roues dentées de vélo pour palier à notre problème de transmission ce qui fut un véritable succès.

34

## F. Conclusion

Nous avons appris à travers notre projet combien il était compliqué développer un kart électrique avec toutes les idées de base que nous avions prévu au départ, que celui-ci requérait de notre part plus de temps que prévu donc un beaucoup plus grand investissement en temps. En effet, pour la partie mécanique et électronique, nous avions dû faire beaucoup de compromis qui nous ont fait perdre un temps fou durant la conception du projet.
Malgré la faite que nous comprenions nos limites dans ce projet, nous sommes arrivés à aboutir notre projet même si le résultat n’est pas celui escompté. Nous avons pu revisiter nos cours d’automaticien et sortir un peu hors de notre zone de confort pour explorer un peu d’autre domaine lors de ce projet qui nous fut bénéfique et dont on retiendra quel sont les approches à avoir avec ce genre de projet, quel difficulté il faut appréhender au préalable et où mettre la barre en début de projet.

35

## G. Sources

CAN SPI:
- https://github.com/pierremolinaro/acan2515
- https://www.locoduino.org/spip.php?article268
ESP32:
- https://randomnerdtutorials.com/esp32-pinout-reference-gpios/ Contrôleur moteur :
- https://usefulldata.com/1000w-dc-brusch-motor-controller/ Moteur à courant continu :
- https://fr.wikipedia.org/wiki/Machine_%C3%A0_courant_continu HC-SR04 datasheet:
- https://cdn.sparkfun.com/datasheets/Sensors/Proximity/HCSR04.pdf 3144 hall sensors:
- https://www.digchip.com/datasheets/parts/datasheet/029/3144-pdf.php

Crémaillaire de direction: http://www.fiches-auto.fr/articles-auto/fonctionnement-d-une-auto/s-1199-la-direction-assistee.php
