Pepito-electronics/Integrated-KART/Schémas 3D/Component8_dashboard v14_base arriere_FusionComponent.stl

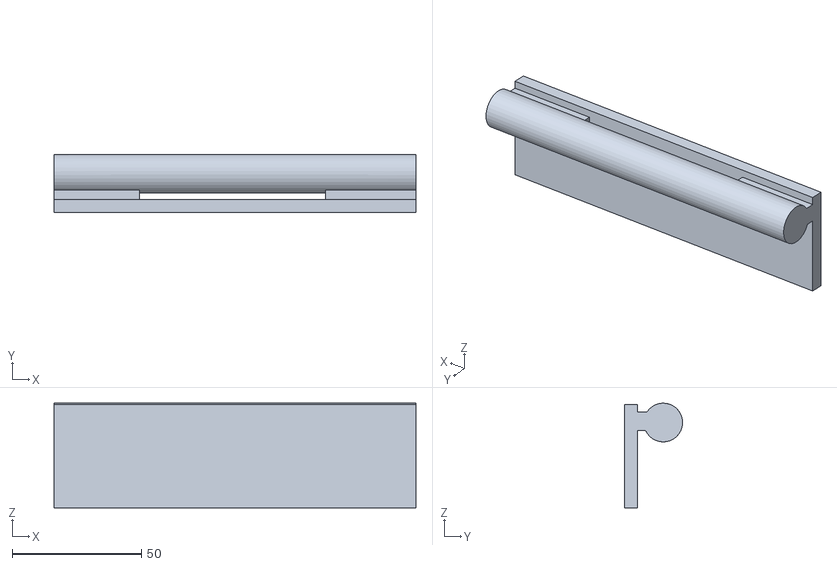
[picture p31: CAD file, 2021-05-20]
Schémas 3D/Component8_dashboard v14_base arriere_FusionComponent.stl
140.0 x 22.5 x 40.5
