Pepito-electronics/Integrated-KART/Schémas 3D/Component8_dashboard v14_morceau arriere couv_FusionComponent.stl

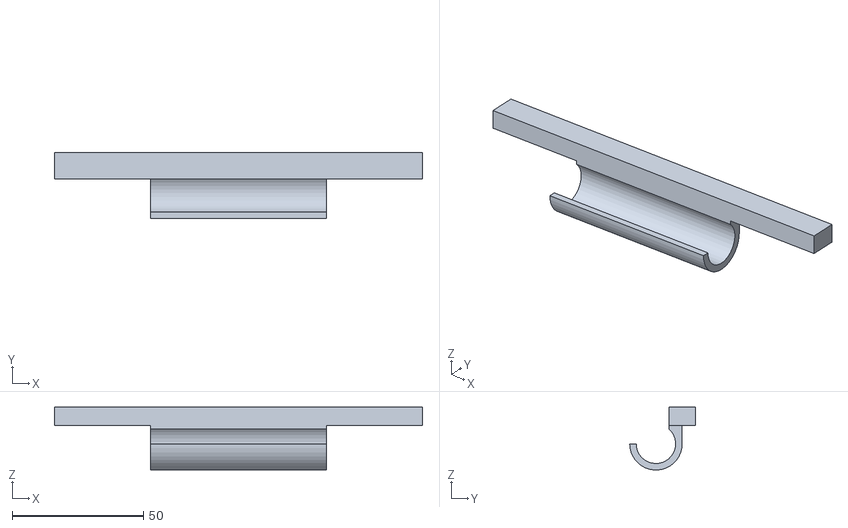
[picture p32: CAD file, 2021-05-20]
Schémas 3D/Component8_dashboard v14_morceau arriere couv_FusionComponent.stl
140.0 x 25.0 x 24.0
