Pepito-electronics/Integrated-KART/Schémas 3D/Component8_dashboard v14_couvercle sans toit_FusionComponent.stl

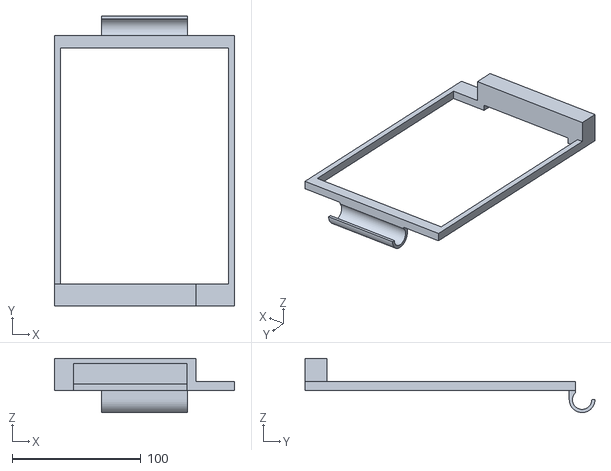
[picture p33: CAD file, 2021-05-20]
Schémas 3D/Component8_dashboard v14_couvercle sans toit_FusionComponent.stl
140.0 x 225.0 x 42.0
