Pepito-electronics/Integrated-KART/Schémas 3D/Component8_dashboard v14_base avant_FusionComponent.stl

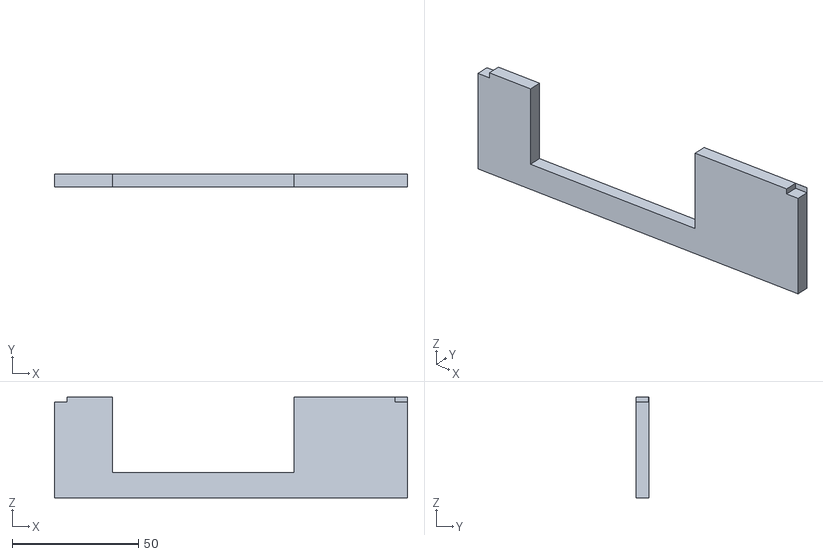
[picture p35: CAD file, 2021-05-20]
Schémas 3D/Component8_dashboard v14_base avant_FusionComponent.stl
140.0 x 5.00 x 40.0
