Pepito-electronics/Integrated-KART/Schémas 3D/Component8_dashboard v14_base sans fond_FusionComponent.stl

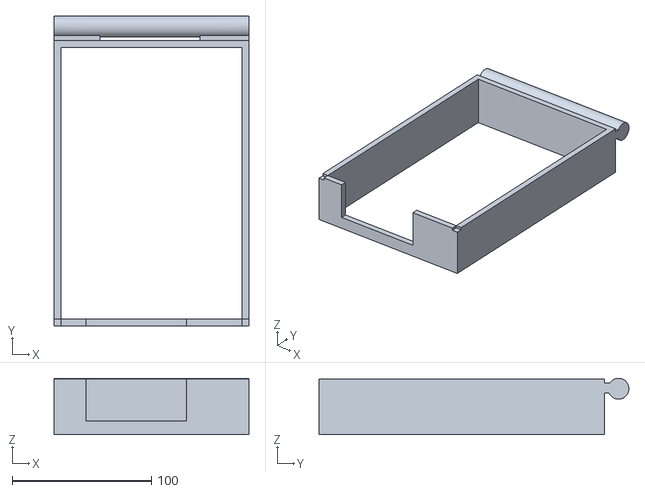
[picture p36: CAD file, 2021-05-20]
Schémas 3D/Component8_dashboard v14_base sans fond_FusionComponent.stl
140.0 x 222.5 x 40.5
