Pepito-electronics/Integrated-KART/(list of files, cad)

Other CAD files:
Schémas 3D/plaque moteur etc.. v7.f3z
