Pepito-electronics/Integrated-KART/pcb/PCB_AcquiCapteur/PCB_acquiCapteur_Schema.brd

## EAGLE design pcb/PCB_AcquiCapteur/PCB_acquiCapteur_Schema.brd (2021-05-20)

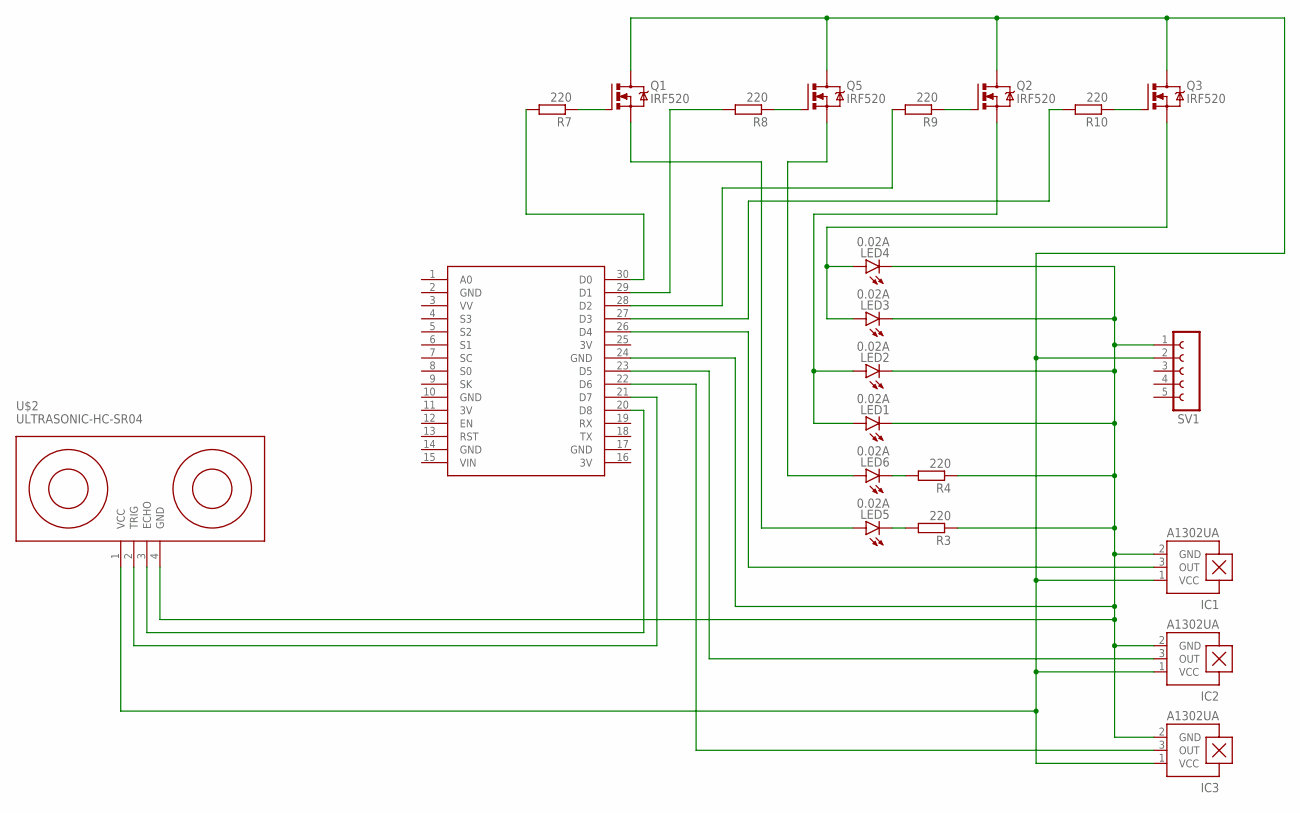
[picture p37: schematic PCB_acquiCapteur_Schema.sch]

Parts:
IC1, IC2, IC3: A1302UA; SIP3-UA
LED1, LED2, LED3, LED4, LED5, LED6: 0.02A; LSU260
Q1, Q2, Q3, Q5: IRF520; TO220BV
R3, R4, R7, R8, R9, R10: 220; 0207/10
SV1: FE05-1
U$1: NODEMCU
U$2: ULTRASONIC-HC-SR04

Connections:
3V: U$1.11 (3V), U$1.16 (3V), U$1.25 (3V)
GND: U$1.2 (GND), U$1.10 (GND), U$1.14 (GND), U$1.17 (GND)
unnamed: LED5.K (C), R3.2
unnamed: LED6.K (C), R4.2
unnamed: IC1.2 (GND), IC2.2 (GND), IC3.2 (GND), LED1.K (C), LED2.K (C), LED3.K (C), LED4.K (C), R3.1, R4.1, SV1.1, U$1.24 (GND), U$2.4 (GND)
unnamed: Q1.G, R7.1
unnamed: Q5.G, R8.1
unnamed: Q2.G, R9.1
unnamed: IC1.3 (OUT), U$1.26 (D4)
unnamed: IC2.3 (OUT), U$1.23 (D5)
unnamed: IC3.3 (OUT), U$1.22 (D6)
unnamed: IC1.1 (VCC), IC2.1 (VCC), IC3.1 (VCC), Q1.D, Q2.D, Q3.D, Q5.D, SV1.2, U$2.1 (VCC)
unnamed: U$1.20 (D8), U$2.3 (ECHO)
unnamed: U$1.21 (D7), U$2.2 (TRIG)
unnamed: Q3.G, R10.1
unnamed: R7.2, U$1.30 (D0)
unnamed: R8.2, U$1.29 (D1)
unnamed: R9.2, U$1.28 (D2)
unnamed: LED3.A, LED4.A, Q3.S
unnamed: LED1.A, LED2.A, Q2.S
unnamed: LED6.A, Q5.S
unnamed: LED5.A, Q1.S
unnamed: R10.2, U$1.27 (D3)

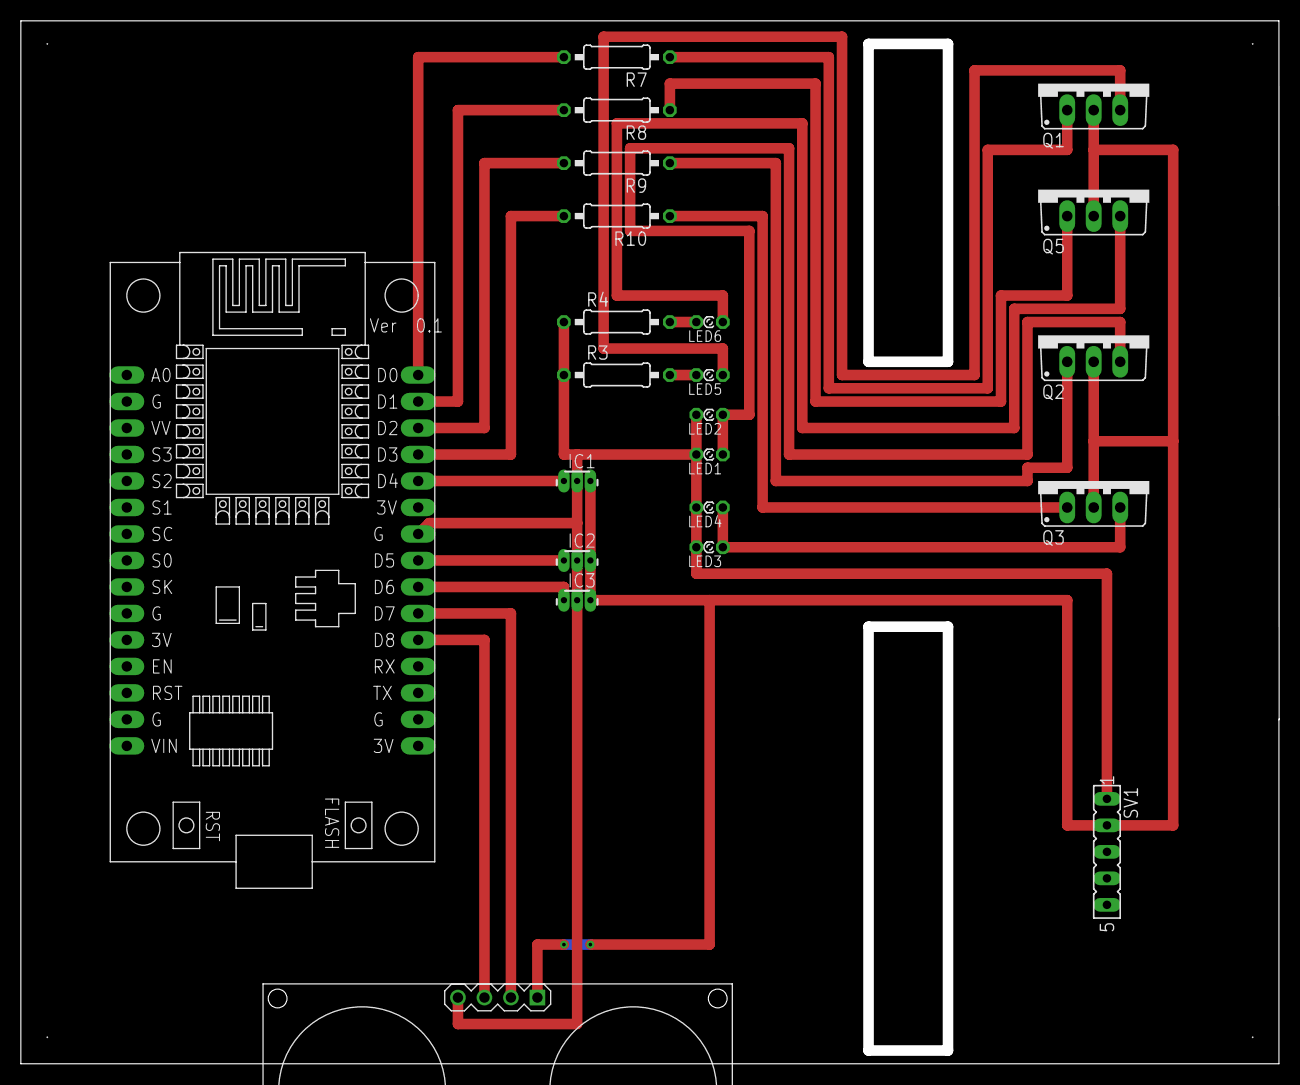
[picture p38: board PCB_acquiCapteur_Schema.brd from above]

Board: 2 copper layers, 120.7 x 100.0 mm, 22 parts (0 on the bottom side), 23 nets.
